cemre-yuce/DC-Motor-Driver-Hardware-Project-EE463/README.md

# DC-Motor-Driver-Hardware-Project-EE463
