cemre-yuce/DC-Motor-Driver-Hardware-Project-EE463/simulation_results/GateDriver.asc

C1: cap; 0.1n
C2: cap; 4.7n
D1: diode
D2: diode
R1: res; 9k
R2: res; 1k
R3: res; 1k
R4: res; 1k
R5: res; 1k
U1: NE555
U2: TLP5702
V1: voltage; 10
Named nets: 0, out_TLP, out_555, V_6, V_pot, Vd_neg
.tran 0.00018
POT (1)
POT (2)
POT (3)
MOSFET Gate Driver
