cemre-yuce/DC-Motor-Driver-Hardware-Project-EE463/simulation_results/analog_controller.asc

A1: and; Vhigh=15 Vlow=0 Trise=10n Tfall=10n
C0: cap; {WDSargC0}; IC={WDSargVout}
C1: cap; {WDSargC1}
C2: cap; {WDSargC2}
C3: cap; {WDSargC3}
D1: diode; DFW
DBODY: diode; DIDEAL
DSW: diode; DID
H1: h; VBUS; {-1.0*{WDSargRI}}
L0: ind; {WDSargL0}; Rser=0m
R1: res; {WDSargR1}
R2: res; {WDSargR2}
R3: res; {WDSargR3}
Rb: res; {WDSargRb}
Rdcr: res; {WDSargRdcr}
Resr: res; {WDSargResr}
Rload: res; {WDSargR0}
Rpwm: res; 1K
Rswitch: res; {WDSargRswitch}
S1: sw; MSW
SPWM: sw; COMP
U1: UniversalOpamp2; Avol=100Meg GBW=1000Meg Slew=100Meg
V1: voltage; {WDSargVref}
VBUS: voltage; {WDSargVs}
VCLK: voltage; PULSE(0 12 0 1f 1f {{{WDSargDswitch_lim}/100}/{WDSargFs}} {1/{WDSargFs}})
VDD1: voltage; 12V
VPWMRAMP: voltage; PULSE(0 {WDSargVramp} 0 {0.99/{WDSargFs}} 1f 0 {1/{WDSargFs}})
Named nets: PWM, 0, VSOURCE, VDRAIN, VOUT, VRAMP, ref, CTRL, VDD, VPWMRAMP
.param LSECarg={{WDSargLm}/{({WDSargNp}*{WDSargNp})}}
.MODEL MSW SW(RON=0.01m Roff=1Meg VT=0.15V)
.MODEL DID D(RON=10m Roff=100K)
.MODEL COMP SW(RON=10m Roff=100k VT=10m)
.tran 0 {WDSargTsim} {WDSargTstart} {WDSargTstep} uic
.LIB OPAMP.SUB
.Param Tr={0.95/{WDSargFs}}
.param WDSargVs=1080.000000000000000
.Param WDSargRswitch=20.0000000000000000m
.Param WDSargL0=25u
.Param WDSargRdcr=0.01
.Param WDSargC0=200u
.Param WDSargResr=32.5636057961645590m
.Param WDSargTstart=4.9500000000000002m
.Param WDSargTstep=1.0000000000000000n
.Param WDSargVramp=1.0000000000000000
.Param Ts={1/{WDSargFs}}
.Param Vlow=0.05
.Param Vhigh=1.0
.Param WDSargLm=0.0000000000000000u
.Param WDSargNp=1.0000000000000000
.IC I(L0)={WDSargIo}
.IC V(VOUT)={WDSargVout}
.Param WDSargIo=2.0000000000000000
.Param WDSargVout=3.2999999999999998
.Param WDSargDswitch=31.5974505200724460
.Param WDSargRxtp=1.0000000000000000m
.Param WDSargRxts=1.0000000000000000m
.MODEL DFW D(RON=0.01m Roff=100K Vfwd={WDSargVdiode})
.Param WDSargVdiode=0.6000000000000000
.Param WDSargR1=10k
.Param WDSargRb=10k
.Param WDSargR2=1393.588
.Param WDSargC1=10n
.Param WDSargC3=4.7n
.Param WDSargC2=10n
.Param WDSargR3=45
.Param WDSargRI=0.4800000000000000
.Param WDSargRsense=10.0000000000000000
.Param WDSargNcs=50.0000000000000000
.Param WDSargVe_ext=0.0000000000000000
.Param WDSargRz=0.0000000000000000k
.Param WDSargVz=3.2999999999999998
.Param WDSargRled=0.0000000000000000k
.Param WDSargRbias=0.0000000000000000k
.Param WDSargRpullup=2.2000000000000002k
.Param WDSargVpullup=8.0000000000000000
.Param WDSargDswitch_lim=90.0000000000000000
.Param WDSargVf=1.3899999999999999
.Param WDSargCTR=123.0000000000000000
.MODEL DLED D(RON=0.01m Roff=100K Vfwd={WDSargVf})
Primary Switch:
Peak Switch Voltage
Average Switch Current
RMS Switch Current
Peak Switch Current
Conduction Losses
Switching Losses
 
Diodes:
Peak voltage stress
Average Current
RMS Current
Peak Current
Conduction Losses
Output Inductor:
Ripple (pk-pk)
Peak Current
Average Current
Power Dissipation
 
Output Capacitor:
RMS Current
Ripple Current (pk-pk)
Peak Voltage
Power Dissipation
Specification:
Vin
Vout
Iout
Vout ripple (pk-pk)
Duty
.measure WDSresVin avg V(VDRAIN)
.measure WDSresVout avg V(vout)
.measure WDSresIo avg I(Rload)
.measure WDSresVr_actual PP V(vout)
.measure WDSresDswitch_avg avg V(pwm)
.measure WDSresDswitch param (WDSresDswitch_avg /15.0)
.measure WDSresL0Iac PP I(L0)
.measure WDSresL0Ipk max I(L0)
.measure WDSresL0Iavg avg I(L0)
.measure WDSresL0pd avg (V(VOUT,N002)*I(Rdcr))
.measure WDSresL0Irms rms I(L0)
.measure WDSresC0Irms rms I(C0)
.measure WDSresC0Iac PP I(C0)
.measure WDSresC0Vpk max V(vout)
.measure WDSresC0pd param  WDSresC0Irms*WDSresC0Irms*{WDSargResr}
.measure WDSresDiodeVpk max V(vsource)
.measure WDSresDiodeIavg avg I(D1)
.measure WDSresDiodeIrms rms I(D1)
.measure WDSresDiodeIpk max I(D1)
.measure WDSresDiodeLoss avg (-V(VSOURCE)*I(D1))
.measure WDSresSwitchVpk max V(VDRAIN,VSOURCE)
.measure WDSresSwitchIavg avg I(S1)
.measure WDSresSwitchIrms rms I(S1)
.measure WDSresSwitchIpk max I(S1)
.measure WDSresSwitchLoss avg (V(N001,VSOURCE)*I(Rswitch))
.Param WDSargA1=1.2285185098461360
.Param WDSargA3=-0.1000359183388560
.Param WDSargB1=1.8000173160223438
.Param WDSargB0=-1.9115445319399298
.Param WDSargA2=-0.1284825915072801
.Param WDSargB2=1.9123196648167622
.Param WDSargB3=-1.7992421831455114
.Param WDSargKpd=0.8753185455376753
.Param WDSargTd=0.5000000000000000
.Param WDSargFsamp=200.0000000000000000k
.MODEL DIDEAL D(RON=0.01m Roff=100K Vfwd=0.01)
.Param WDSargCopto=2.7999999999999998n
.Param WDSarggm=100.0000000000000000u
.Param WDSargFs=22.0000000000000000k
.Param WDSargVref=90
.param WDSargTsim=15.0000000000000000m
.Param WDSargR0=13.846
