cemre-yuce/DC-Motor-Driver-Hardware-Project-EE463/(commit log)

2025-01-20 PCB Files are added.
2025-01-20 MOSFET datasheet added
2025-01-20 Dİode datasheet added.
2025-01-20 NE555 timer datasheet added.
2025-01-20 Analog controller PID that simulated in LTspice
2025-01-20 Analog Gate Driver that designed in the first phase
    without feedback
